BradROlbrey/Photo-Machine/readme.md

## Photogrammetry Machine

After discovering the concept of photogrammetry - synthesizing pictures of an object or scene to make a 3D model of it - I decided to make a robot to take pictures of items for me, so I could have 3D models of them!

A Raspberry Pi with a camera module takes pictures and controls an Arduino over I2C. Between each picture, the pi signals the Arduino to move the camera. The Arduino controls two TMC2208 stepper drivers, each of which controls a stepper motor. One motor is for rotating the camera armature around the object, and the other is for sliding the camera up and down the arm. In this manner, pictures can be taken all around an object. I decided to spin the camera around the object instead of simply spinning the object itself; this way the background moves with the image, so as to not confuse the image processing software.

The Pi also provides Ethernet/USB so I can conveniently get those pictures to a more powerful computer. The pictures are imported into [Meshroom](https://alicevision.org/) (I had no part in creating this), which processes them to construct a textured 3D model of the object.

The orange pieces in the pictures below are all parts I 3D modeled in Autodesk Inventor and 3D printed on my Prusa MK3.

## How It Works

This is the setup of the first design.
setup
The Raspberry Pi and Arduino are on top of the table, while the mechanical part sits on a box below. The ribbon cable for the camera and the wires for the stepper motors come down, and this arrangement keeps them out of the way of the arm as it rotates. The big light strip across the top is to provide even lighting onto the object, and to prevent hard shadows. 

I set the pinecone in the middle, and set the Pi to take 400 pictures of the object - 40 around by 10 up-and-down. Meshroom was able to piece together most of them over the course of 2-3 hours on my 6800k and gtx 970.
Grid-of-cameras

Meshroom creates a .obj file with texture maps, which imported flawlessly into Blender. I used Blender to trim away some of the extra vertices Meshroom incorporated from the environment around the pinecone and the spray-can cap it was sitting on.


The lighting of the scene the object was photoed in is preserved, baked into the texture maps, so the following image was rendered with Blender's Eevee engine, i.e. in real time without the need for ray-tracing.


## New Design

Same functionality but in a more put-together form factor, aside from the lighting. My dad did the metalwork (pop rivets and aluminum bending/cutting). The arm is the same, carried over from the previous model. The electronics are the same as well, but whereas previously they were strewn about the table top, they are now mounted to the frame of the photomachine. The camera appears to have ran off at some point.
1-overview-2_cropped

Below is the Raspberry Pi, and above is the breadboard with the other components. Power comes in through the barrel plug in between. 

Raspberry Pi Mounted CloseUp

On the left is a dc-to-dc converter for power. In the middle are the two TMC2208 stepper drivers, and on the right is the Arduino that controls them. The stepper motors run on 12V, passed through from the stepper drivers, while the drivers themselves run on 5V provided by the converter. The Arduino and Raspberry Pi also run on 5V.
2-electronics_cropped

New upper stepper motor mount. Closeup of the wheel-reel mechanism on lower stepper motor. Lots of slack in the ribbon cable, and the lower stepper's wires, for when the arm spins 360 around the object. Don't mind the masking tape :)



Closeup of camera mount (an earlier version, still on the printbed no less!) with camera, showing it slotted into place.



Closeup of camera mount (current version) without camera but attached to arm. You can see the eye screws where the fishing line attaches, allowing the lower stepper motor and its wheel/reel to pull the camera up and down the arm.



Closeup of the Raspberry Pi mounts. The mounts for the breadboard are similar. The arch gives it some spring to clamp the Pi and aluminum bar tight, keeping each side secure.

Raspberry Pi Mounts CloseUp_crop1

## Thoughts

In the future, I would like to improve the frame by incorporating laser-cut plywood, especially for the arm. This would allow the arm to be much bigger instead of being constrained to the area of a 3D printer printbed, allowing the photo machine to take pictures of larger objects.
