BradROlbrey/Photo-Machine/(commit log)

2019-10-06 second motor, camera slides up and down
2019-10-06 Arduino takes wasd input from pi
2019-10-06 pi has optimized wait for arduino
2019-10-06 camera movement in scoot_camera function
2019-10-06 disable motors so we can manually position machine, reenable afterwards
2019-10-06 send move counts to arduino
2019-10-06 arduino moves all properly according to pi
2019-12-16 Added PiCamera to PhotoMachine.py, takes pictures! Tweaks and a fix to PhotoMachine.ino
    [PhotoMachine.ino, PhotoMachine.py]
2019-12-16 Major changes
    Instead of rotating around and then moving up a level, camera now takes pictures all the way up, returns back down, and then rotates around one move. This keeps the ribbon cable from bunching up and tangling with things as the armature rotates.
2020-01-03 Blocking moves in switch statement
2020-01-04 Changed up switch-case statements a lil
2020-01-04 Stepper returns using absolute positioning
2020-01-05 Non-blocking switch-case statement. Probably won't work
    [PhotoMachine.ino, PhotoMachine.py]
2020-01-10 Massive software overhaul
    There may be a hidden bug lurking somewhere that causes the slider to keep going down when it's supposed to go back up...
    [PhotoMachine.ino, PhotoMachine.py]
2020-01-11 Separate TMC2208Stepper objs for each stepper driver
2020-01-11 Set microstepping and speed and acceleration in Arduino
2020-01-19 bugfix: reset AccelStepper's positions to 0 when receiving setup ints because user might have manually repositioned the armature
    [PhotoMachine.ino]
2020-01-19 feature: signal handling
    ctrl+C resets armature to initial position, ctrl+Z pauses program and allows user to continue by pressing enter
    [PhotoMachine.py]
